MerlinDesigns/hardware/em-controller-2/README.md

# Em Controller Version 2
This smaller Em controller, also affectionately nicknamed "Springspinne" (German for jumping spider), is a hand-held all-button game controller based on the [Em controller](../em-controller) with a focus on being more compact and easier to build. It's running the amazing [GP2040-CE](https://gp2040-ce.info/) firmware.

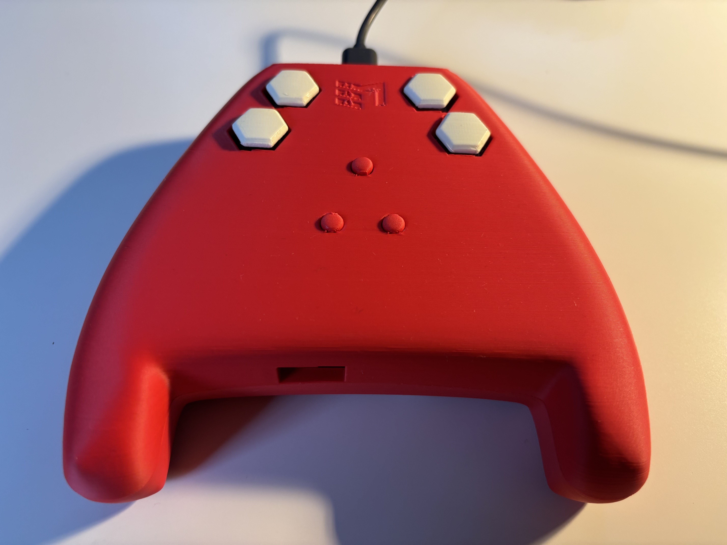
[picture p1: em-controller-2/pictures/em2-top-view.jpg]
Picture of the Em2 from the top. It has two buttons on the top left, two buttons on the top right, and three smaller menu buttons in a cluster in the middle. It is 3D printed in a red color with white hexagonal buttons. A USB-C cable is connected to the controller. The Em2


The idea is that most of the buttons are on the bottom side of the controller
and you can press them with your various fingers. The design aims to let you
use the same fingers for the same buttons you would use on more traditional
leverless controllers.

![Picture of the Em2's bottom. It is 3D printed in red PLA. On that surface, there are
ten white, hexagonal buttons. From this perspective there are seven buttons on the left
and three buttons on the right. The left buttons are clustered similar to
sideways arcade buttons with an additional button on the top. The right buttons are arranged in a staggered line](pictures/em2-bottom-view.jpg "The business end of
the Em2")

This time around there's also a "southpaw" version of the controller:

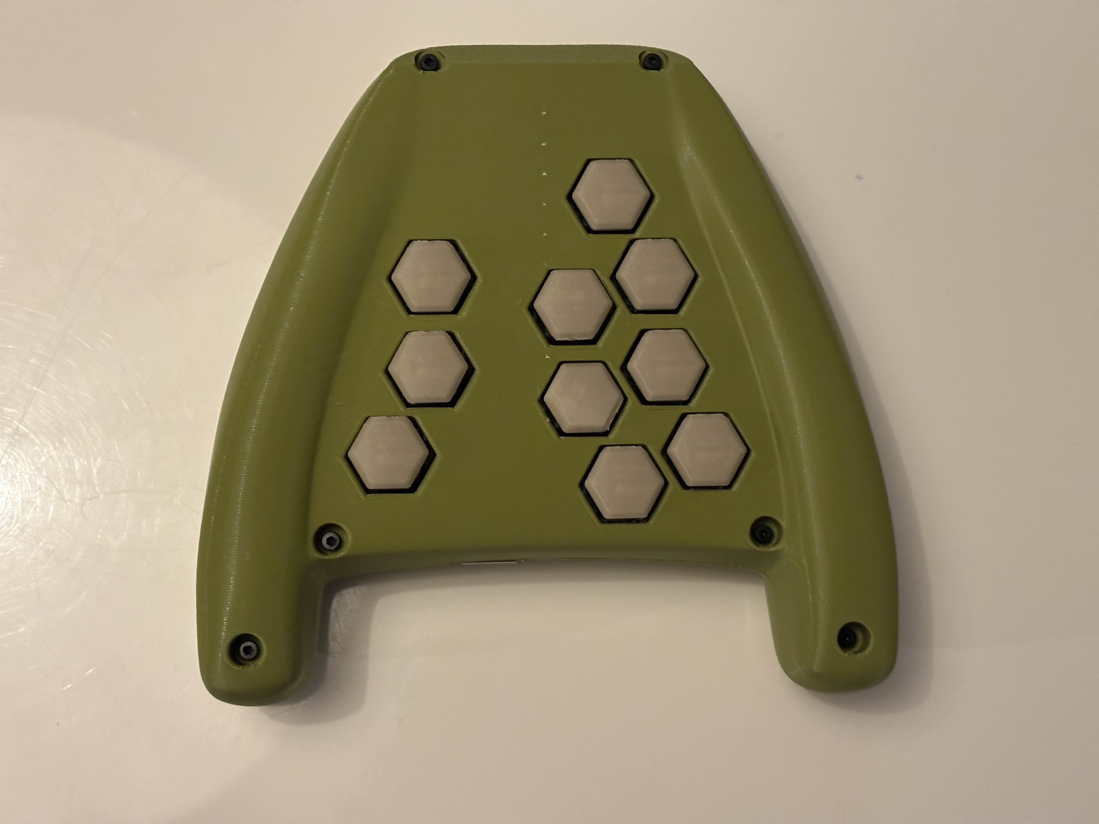
[picture p2: em-controller-2/pictures/southpaw-bottom.jpg]
Picture of the Em2 in olive green with cream colored buttons, bottom side. Here, the cluster of 7 buttons is on the right side of the picture, while the line of 3 buttons is on the left.


This is the button layout I am using (you can change it however you like)
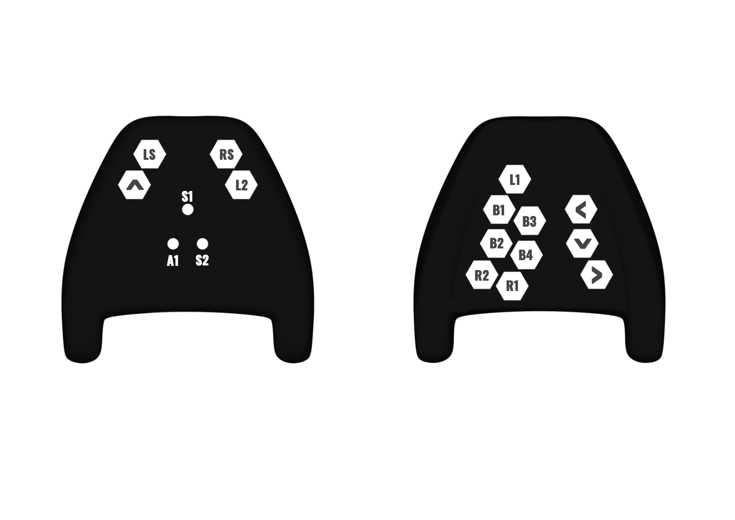
[picture p3: em-controller-2/pictures/springspinne_layout.png]
Diagram of the Em2 and the button assignments


I recorded some videos to make it more clear how its used starting with
a top/front view:

Video showing how the Em2 is used, shot from the front. It shows someone holding the controller and Street Fighter 6 in the background. The player does a simple combo with Blanka in training mode. (https://youtu.be/TEalYefYmOo)

And here is a video from the bottom/back doing the same combo:

Video showing how the Em2 is used, shot from the bottom. Only the controller and two hands wrapping around it are visible. The fingers wiggle around between the different buttons while the player does a simple combo in street fighter 6 (https://youtu.be/E2yLD4zI1v8)

## Why this form factor?
The idea is to have something more like a game pad and the ability to laze
around on the couch while also having the benefits of a leverless controller.
Like a flatbox without having to have the controller on the lap. While you
could just use a gamepad for this purpose, I have been unhappy with most, if
not all, dpads and wanted to be able to not miss the benefits of more detailed
control of directional input.

## How can I get my own?
Some soldering equipment and skill is required for both the handwired and the PCB version. The handwired variants are entirely 3D printed and then soldered with wires, the PCB version can be ordered from the PCB production service of your choice but will still require some soldering of components.

There are a few variants to decide between when building your own controller.
First of all, there is the decision whether you want to build the left-handed (southpaw)
or right-handed (regular) version. For either, there are separate folders including
different print files.

Secondly, the shell files come either with or without prebuilt supports. The
prebuilt supports can help with preventing the controller from being printed
unevenly but aren't strictly needed and might also leave some marks on the
shell.

Whether you pick the PCB or the handwired version, the files are the same but for the fact that you don't need the PCB-replacement files for the real PCB version and the menu buttons are a different size for PCB and handwired version.
### What you'll need for the PCB version
- 1x printed top shell
- 1x printed bottom shell
- 14x printed button caps from `right-handed/buttons/hex-buttons.stl` or 14x of the printed flat button caps from `right-handed/buttons/flat-hex-buttons.stl`
- 3x printed menu buttons from `right-handed/buttons/menu-button-pcb.stl`
- 1x printed bottom switch support from `right-handed/pcb-files/switchfence.stl`
- 1x printed top switch support from `right-handed/pcb-files/switchfence-top.stl` 
- 1x PCB (see below on how to order this)
- 1x Waveshare RP2040-Zero (or equivalent)
- 14x Cherry MX-style full-sized keyboard switches (I have used Cherry MX Speed
  Silver and Akko V3 Silver Pro and I prefer the Akko ones)
- 4x 6mm x 6mm x 8mm push buttons or similar
- 1x female USB A port
- 6x 16mm m2 screws
- 4x 6mm m2 screws
- 10x m2 nuts

top view of the assembled PCB


bottom view of the assembled PCB


When assembling, you need to make sure that the legs of the 6mm x 6mm buttons that overlap with the keyboard switches are snipped off, so that they don't keep the keyboard switches from sitting flush. Two legs being soldered on are enough to provide the functionality and the stability you need. 

When soldering the Waveshare board to the PCB, try to make sure it is soldered on straight and evenly spaced on both sides. Otherwise, the USB plug won't sit correctly in the controller case. You can try soldering on the board using just one of the pins and then check the fit with the case if you are in doubt. For fit checks, it's recommended to also screw the board into the top shell piece to make sure the alignment is correct.

#### How to Order the PCBs
1. Go to JLCPCB.com
2. Click on "Order now"
3. Click on "Add gerber file" and choose "gerber-springspinne.zip"
4. Use the default options (see reference at the end of these instructions), except those mentioned here:
    - PCB Color: choose your color, we would recommend purple
    - Surface Finish: HASL, we would recommend LeadFree
    - Confirm Production file: Yes
5. Click "SAVE TO CART"

Please bear in mind: Do this at your own risk. It is your own responsibility to do the ordering process. We are not responsible for any mistakes in this instruction, as the actual ordering process might change at any time.
<details><summary>Click to see default options for reference</summary>

    PCB: 
    - Base Material: FR-4
    - Layers: 2
    - Dimensions: do not touch
    - PCB Qty: 5 is minimum
    - Product Type: Industrial/Consumer electronics
    - Different Design: 1
    - Delivery Format: Single PCB
    - PCB Thickness: 1.6mm
    - Silkscreen: White
    - Outer Copper Weight: 1oz
    - Via Covering: Tented
    - Min via hole size/diameter 0.3mm
    - Board Outline Tolerance: +/-0.2mm
    - Mark on PCB: Remove Mark
    - Electrical Test: Flying Probe Fully Test
    - Gold Fingers. No
    - Castellated Holes: No
    - Edge Plating: No
</details>

### What you'll need for the handwired version
- 1x printed top shell
- 1x printed bottom shell
- 14x printed button caps from `<layout-choice>/buttons/hex-buttons.stl` or 14x of the printed flat button caps from `<layout-choice>/buttons/flat-hex-buttons.stl`
- 3x printed menu buttons from `<layout-choice>/buttons/menu-button-handwired.stl`
- 1x printed switch support plate from `<layout-choice>/pcb-replacement/switch-support-plate.stl`
- 1x printed menu support plate from `<layout-choice>/pcb-replacement/menu-button-holder.stl`
- 1x printed waveshare holder from `<layout-choice>/pcb-replacement/board-holder.stl`
- 1x Waveshare RP2040-Zero (or equivalent)
- 14x Cherry MX-style full-sized keyboard switches (I have used Cherry MX Speed
  Silver and Akko V3 Silver Pro and I prefer the Akko ones)
- 4x Kailh Silent switch for mice (or similarly sized substitutions)
- 4x m2 heat set inserts (I use Ruthex)
- 1x female USB A breakout board. I got [these
  ones](https://www.amazon.de/Keenso-Breakout-Female-Adapter-Connector/dp/B07VBRTDVF) 
- 6x 16mm m2 screws
- 8x 6mm m2 screws
- 10x m2 nuts
- a bunch of wire to connect everything (I use AWG 26 stranded wire but other wire will work the same)

Inside picture of the Em2. Everything is printed in red matte PLA. There is a Waveshare RP2040-Zero on the inside. A lot of cables connected to the RP2040-Zero via soldering. The controller's insides


Picture of the Em2 switch support plate from the other side showing where the cables go on the other side. The controller's inside, flip side


### Printing Notes

The shell halves are designed to be printed standing on their "noses", which is
why there is a flat plane on those noses. This is not the prettiest, but
a good trade-off to get a nice print. This way the controller can be printed at
a 45 degree angle, which should also work well with the hexagonal cutouts for
the buttons. The inside of the shells should be on the upside when printing to
avoid having to use a lot of supports for the different standoffs etc.

Print settings for the shells should be fine with mostly defaults. My
recommendation is to enable tree supports but only from the build plate to
prevent supports within the nut slots. Other than that you can change infill
settings however you like. Let me know if you encounter problems with printing
so I can make adjustments. I tested the print in PLA and PETG.

Fun fact: You can fit both shell halves on the build plate of Bambu Lab A1 mini.

Print the menu buttons on their flat side edge without supports.

I've had success with printing the hexagonal button caps on one of their edges
with normal supports enabled and two raft layers. This allows the convex shape to be printed
without problems.

If the button caps come out inconsistent on your printer, you can use the flat hex buttons instead. These can just be printed face down and should come out nicely. You should probably enable "detect thin walls" or similar in your slicer.

The switch support plate has a chamfer on one edge that I recommend to use to
print on. Tree supports are required for this print.

I usually print the menu button holder face down with normal supports. This
will require removal of the supports with some tweezers or similar. 

The waveshare board holder arm can easily be printed without supports.

## Thank You

Big thanks to [Alpenmeister](https://alpenmeister.com/en) for being a constant sounding board on the design and especially for his work on the PCB.

Thank you to Giga on the GP2040-CE Discord for giving the design a spin and everyone else on the GP2040-CE Discord for advice and encouragement throughout development.

## Support
If you want to support this project you can [buy me
a coffee](https://ko-fi.com/merlindesigns).

## License
This project is published under [CC BY-NC-SA
4.0](https://creativecommons.org/licenses/by-nc-sa/4.0/). If you want to sell
this design, please contact me first.

If you have questions, you can find me (@Merlin) in the [Open Stick Community
Discord Server](https://discord.com/servers/openstickcommunity-1049366310389289001). Or @merlindesigns.bsky.social on Bluesky.
