MerlinDesigns/hardware/flatbox-box/README.md

# Flatbox Box

**WIP**

Currently just a silly idea on how you could support a flatbox on your lap at
your local. This is completely unproven as of writing.
