MerlinDesigns/hardware/em-controller-2/pictures/em2-bottom-view.jpg

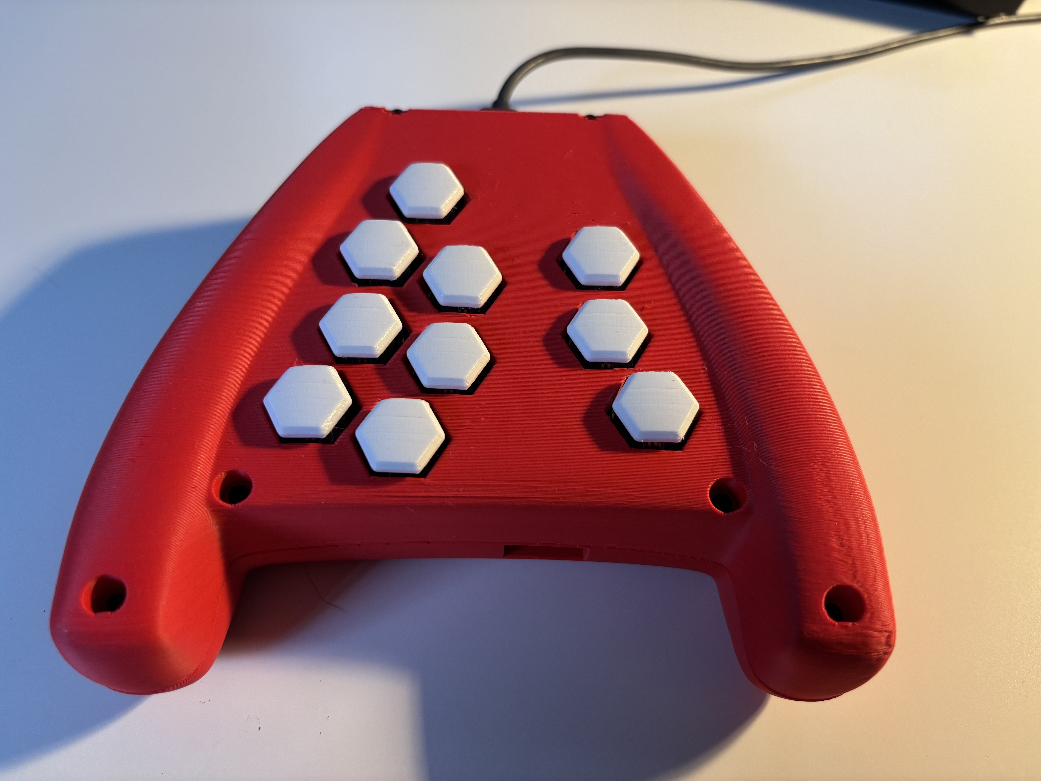
em-controller-2/pictures/em2-bottom-view.jpg
