MerlinDesigns/hardware/em-controller-2/pictures/southpaw-top.jpg

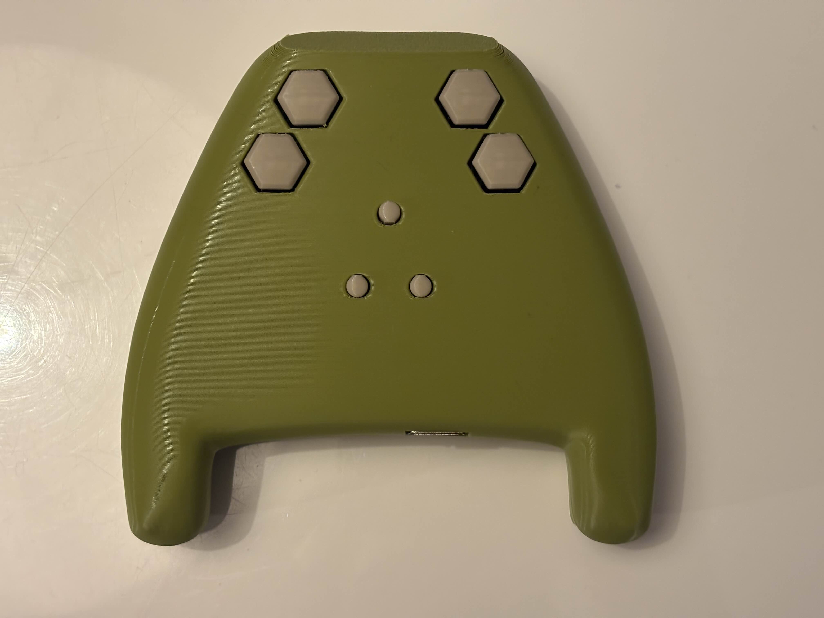
em-controller-2/pictures/southpaw-top.jpg
