MerlinDesigns/hardware/em-controller/pictures/bottom-slice.png

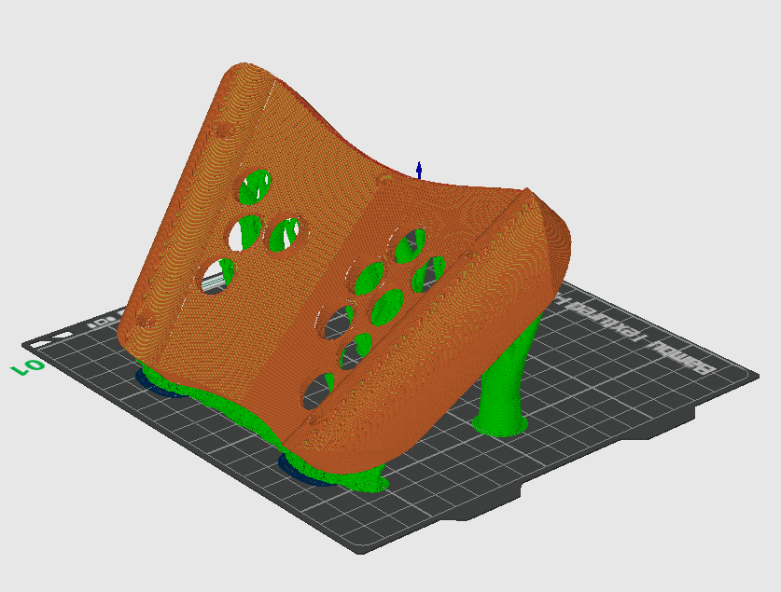
em-controller/pictures/bottom-slice.png
