MerlinDesigns/hardware/em-controller/pictures/em-controller-bottom-pinout.png

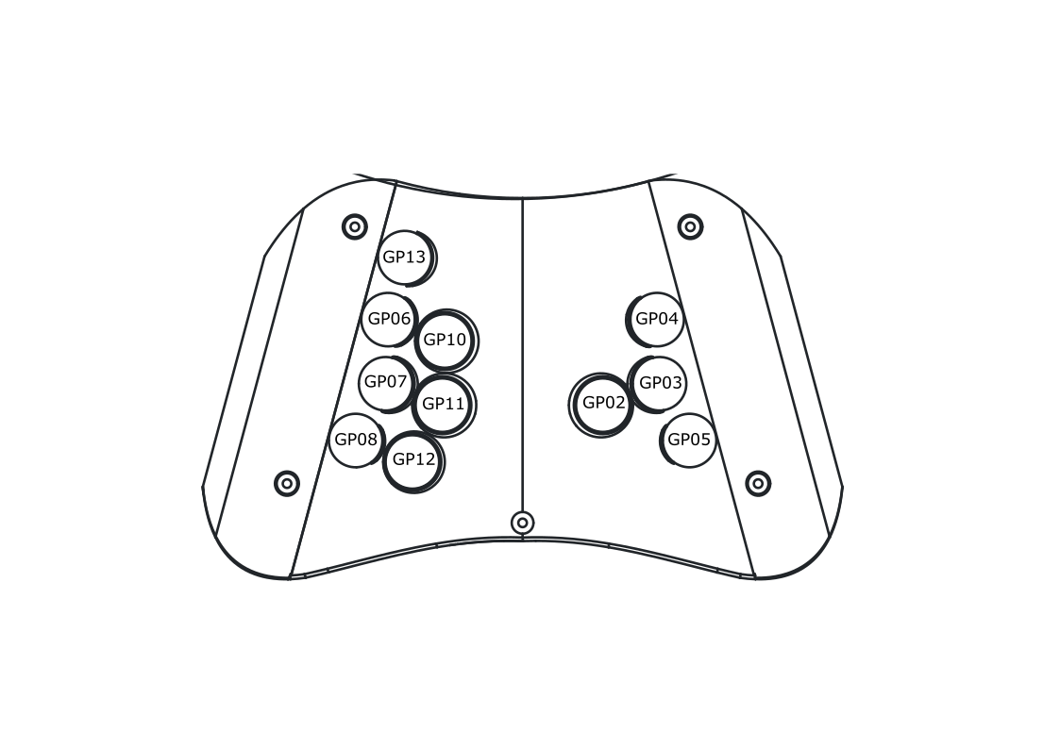
em-controller/pictures/em-controller-bottom-pinout.png
