MerlinDesigns/hardware/em-controller/pictures/holding.jpg

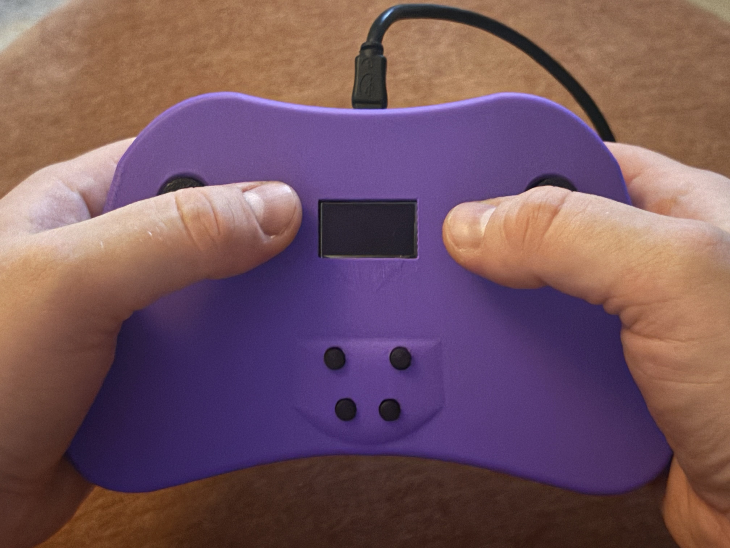
em-controller/pictures/holding.jpg
