MerlinDesigns/hardware/em-controller/pictures/outside-pic-bottom.jpg

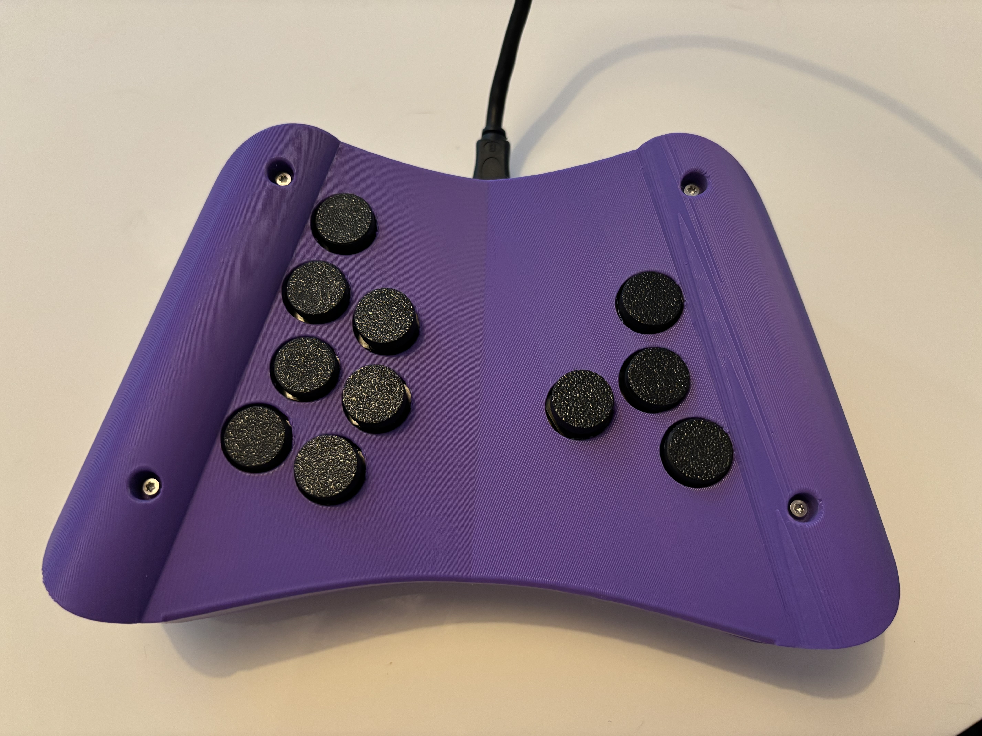
em-controller/pictures/outside-pic-bottom.jpg
