MerlinDesigns/hardware/em-controller-2/left-handed/buttons/flat-hex-buttons.stl

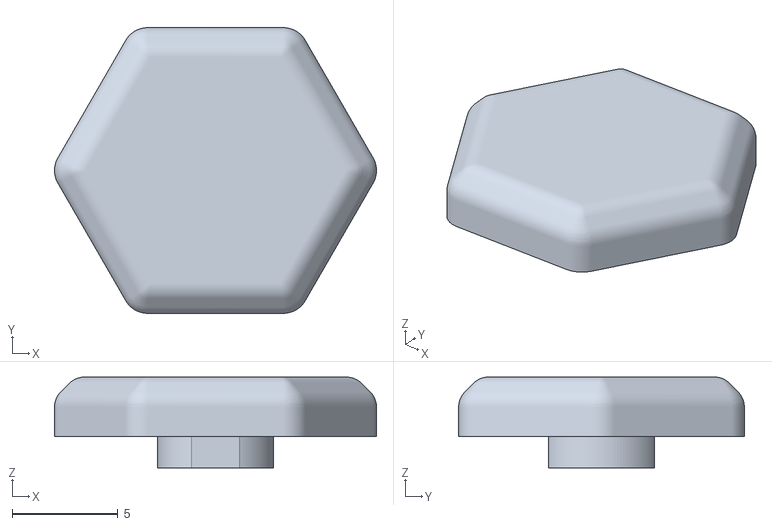
[picture p18: CAD file, 2025-11-20]
em-controller-2/left-handed/buttons/flat-hex-buttons.stl
15.2 x 13.5 x 4.30
