MerlinDesigns/hardware/em-controller-2/left-handed/pcb-replacement/menu-button-holder.stl

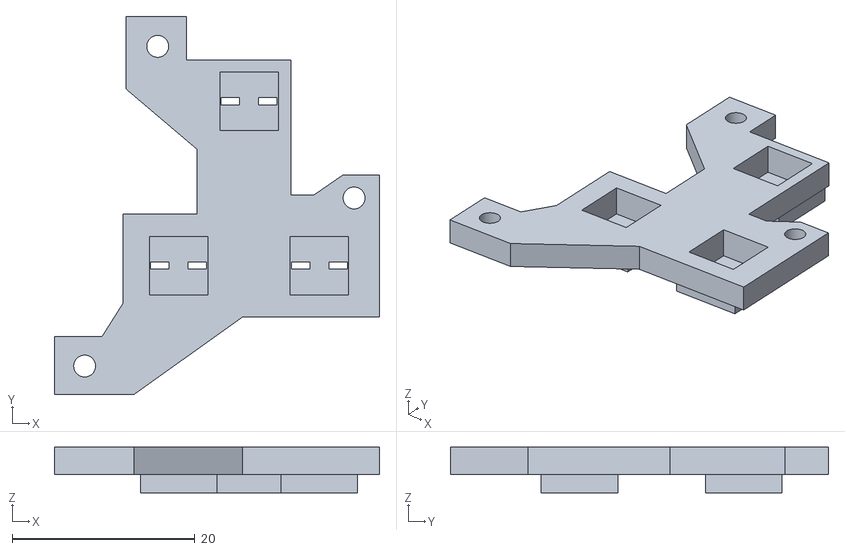
[picture p19: CAD file, 2025-11-13]
em-controller-2/left-handed/pcb-replacement/menu-button-holder.stl
35.6 x 41.4 x 5.00
