MerlinDesigns/hardware/em-controller-2/right-handed/buttons/menu-button-pcb.stl

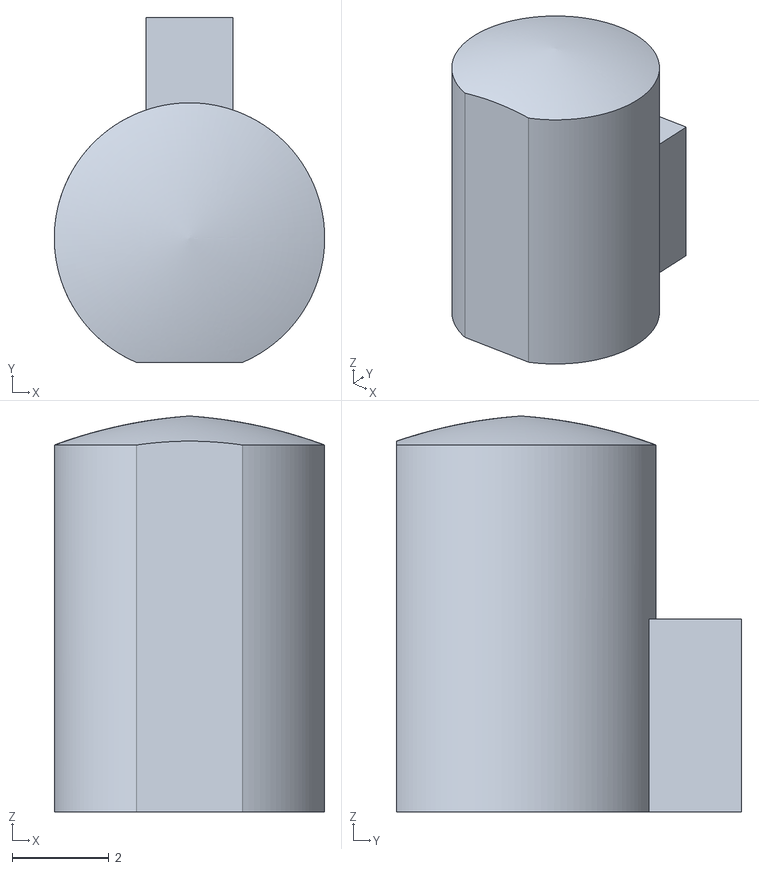
[picture p20: CAD file, 2025-12-09]
em-controller-2/right-handed/buttons/menu-button-pcb.stl
5.60 x 7.15 x 8.20
