MerlinDesigns/hardware/em-controller-2/right-handed/pcb-files/switchfence-top.stl

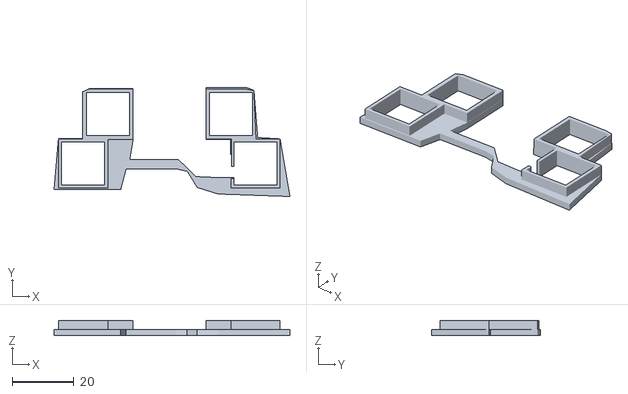
[picture p21: CAD file, 2025-12-09]
em-controller-2/right-handed/pcb-files/switchfence-top.stl
76.6 x 35.4 x 5.00
