MerlinDesigns/hardware/em-controller/model files/em-controller-menu-button-top.3mf

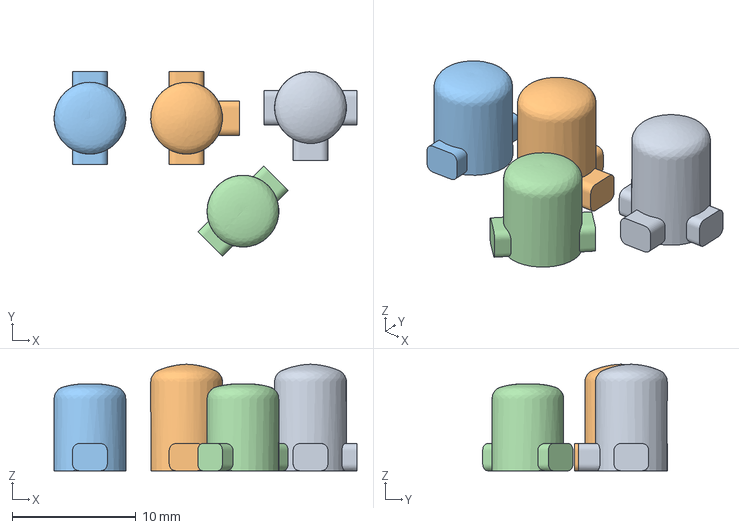
[picture p22: CAD file, 2024-12-14]
em-controller/model files/em-controller-menu-button-top.3mf
24.4 x 14.9 x 8.60 mm
em-controller-menu-button-top.stl x 2
em-controller-menu-button-bottom.stl x 2
