MerlinDesigns/hardware/em-controller/print files/button-print.3mf

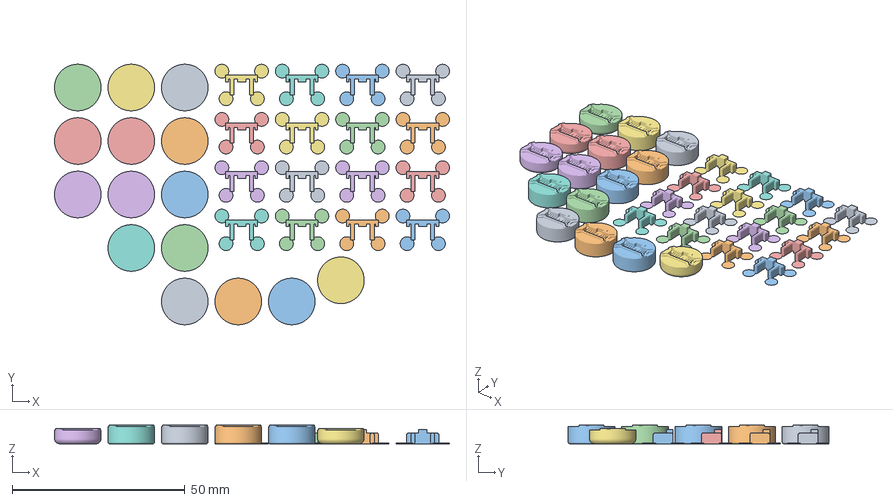
[picture p23: CAD file, 2024-12-14]
em-controller/print files/button-print.3mf
114.4 x 75.5 x 5.41 mm
stem_pads_r6.STL x 16
buttoncaps-bottom.stl x 11
buttoncaps-top.stl x 4
