MerlinDesigns/hardware/flatbox-box/flatboxbox.FCStd

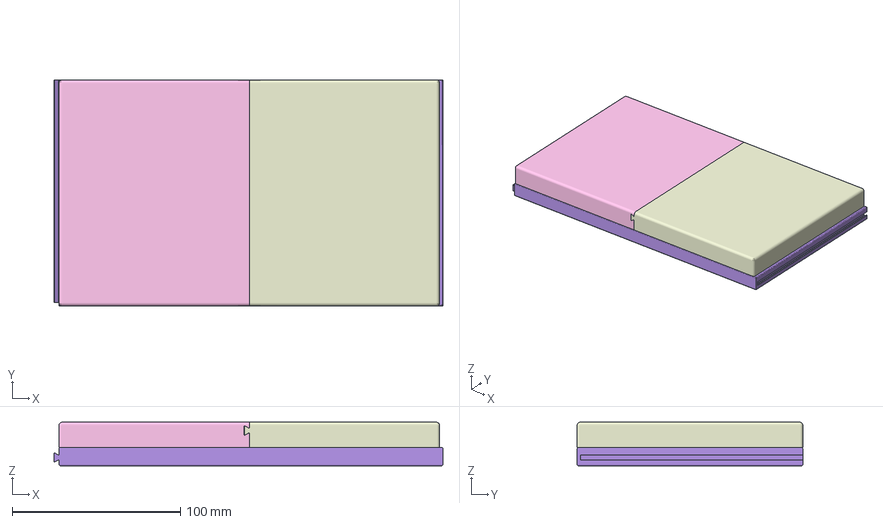
[picture p24: CAD file, 2024-08-21]
flatbox-box/flatboxbox.FCStd
230.9 x 134.0 x 26.0 mm
bottom
topleft
topRight
Flatbox-rev5-Bottom-hotswap
Flatbox-rev5-Top
