MerlinDesigns/hardware/mini-arcade-button/mini-arcade-button.FCStd

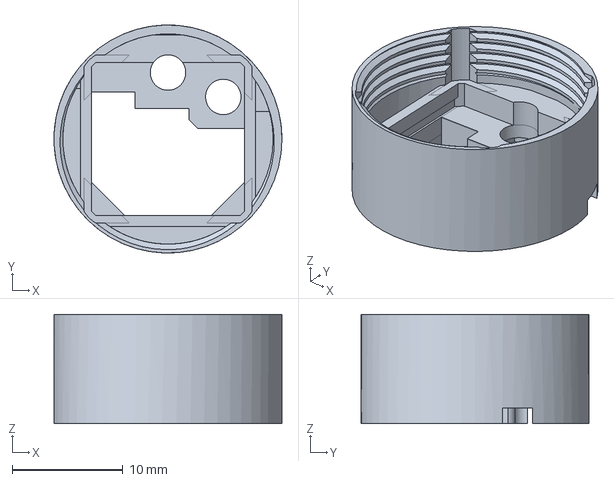
[picture p25: CAD file, 2024-08-14]
mini-arcade-button/mini-arcade-button.FCStd
20.6 x 20.6 x 9.85 mm
