MerlinDesigns/hardware/mini-arcade-button/print files/stem_r6.STL

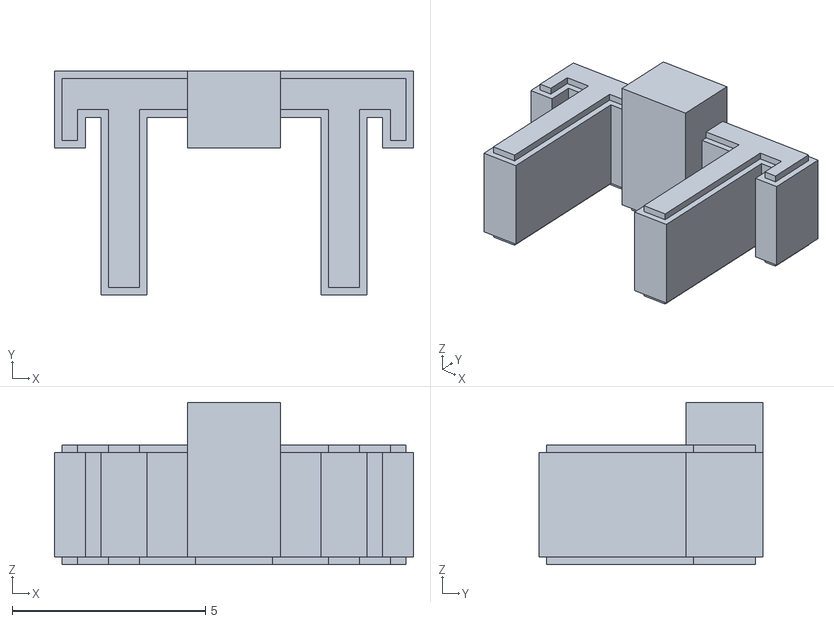
[picture p26: CAD file, 2024-08-14]
mini-arcade-button/print files/stem_r6.STL
9.29 x 5.80 x 4.20
