MerlinDesigns/hardware/em-controller-2/left-handed/buttons/hex-buttons.stl

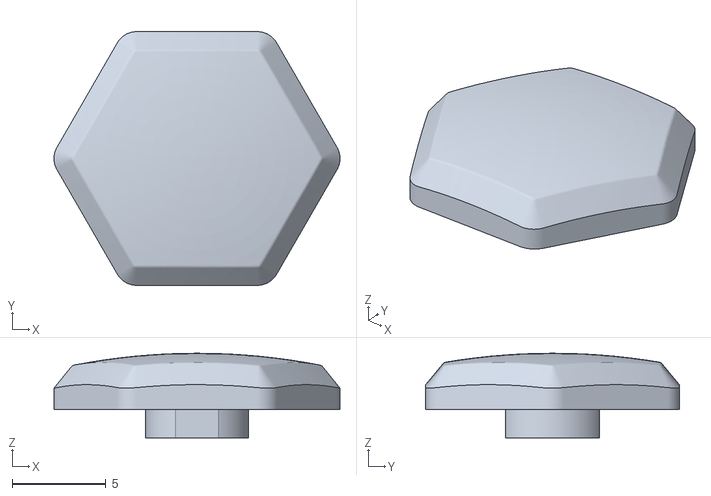
[picture p27: CAD file, 2025-11-13]
em-controller-2/left-handed/buttons/hex-buttons.stl
15.2 x 13.5 x 4.50
