MerlinDesigns/hardware/em-controller-2/left-handed/pcb-replacement/switch-support-plate.stl

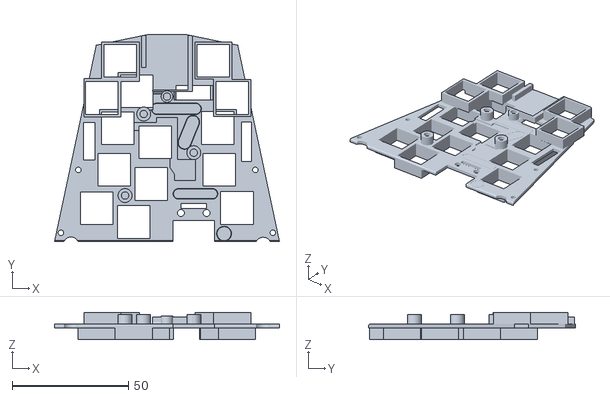
[picture p28: CAD file, 2025-11-13]
em-controller-2/left-handed/pcb-replacement/switch-support-plate.stl
96.6 x 89.0 x 11.6
