MerlinDesigns/hardware/em-controller-2/right-handed/pcb-files/switchfence.stl

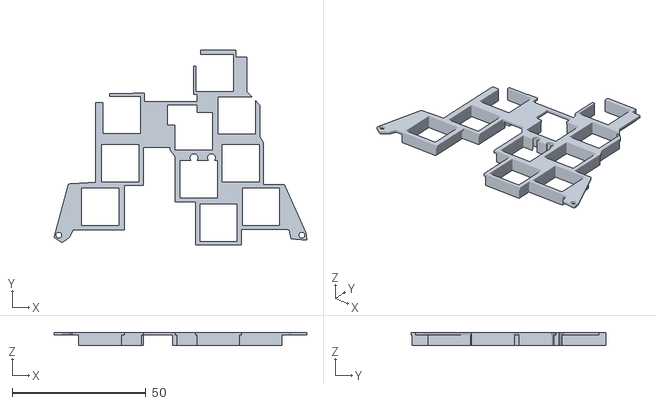
[picture p29: CAD file, 2025-12-09]
em-controller-2/right-handed/pcb-files/switchfence.stl
94.7 x 73.0 x 5.00
