MerlinDesigns/hardware/em-controller/model files/em-controller-menu-button-bottom.stl

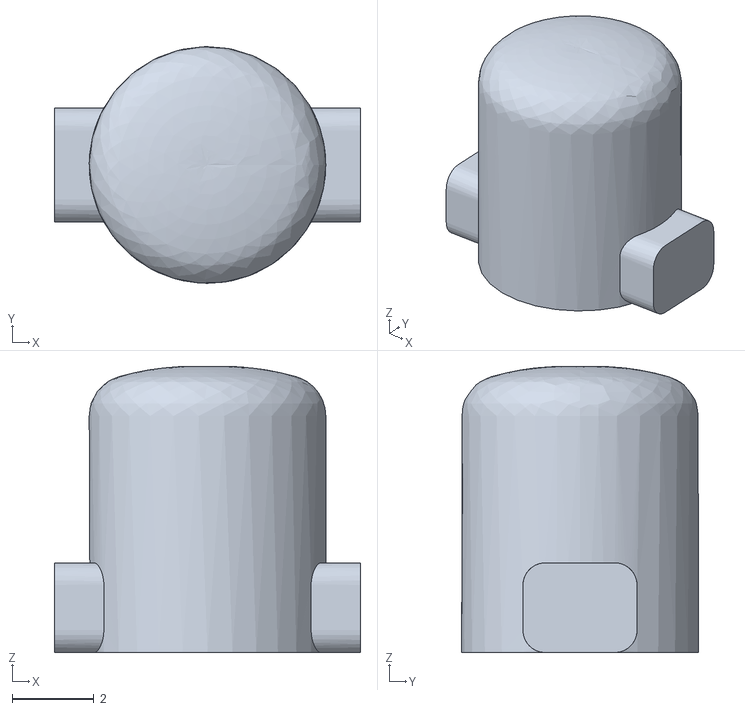
[picture p30: CAD file, 2024-12-14]
em-controller/model files/em-controller-menu-button-bottom.stl
7.50 x 5.80 x 7.01
