MerlinDesigns/hardware/em-controller/print files/em-controller-topsupport.3mf

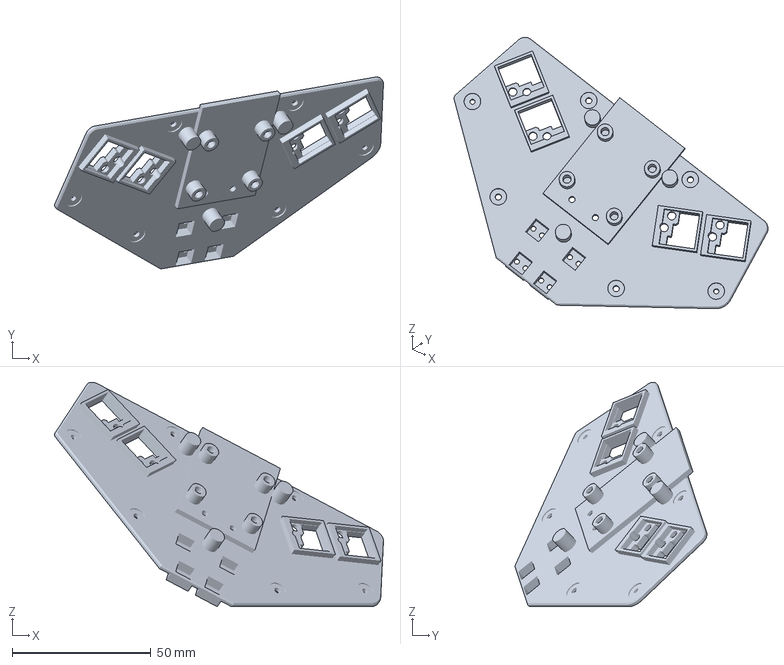
[picture p31: CAD file, 2024-09-05]
em-controller/print files/em-controller-topsupport.3mf
118.4 x 69.1 x 80.8 mm
