MerlinDesigns/hardware/flatbox-box/flatboxbox-topRight.stl

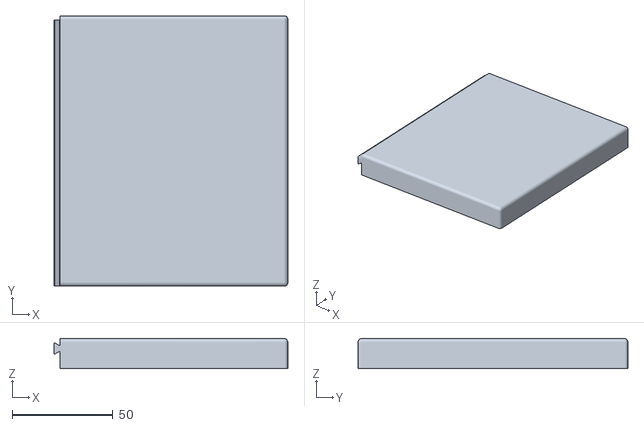
[picture p32: CAD file, 2024-08-21]
flatbox-box/flatboxbox-topRight.stl
116.0 x 134.0 x 15.0
