MerlinDesigns/hardware/mini-arcade-button/print files/top.stl

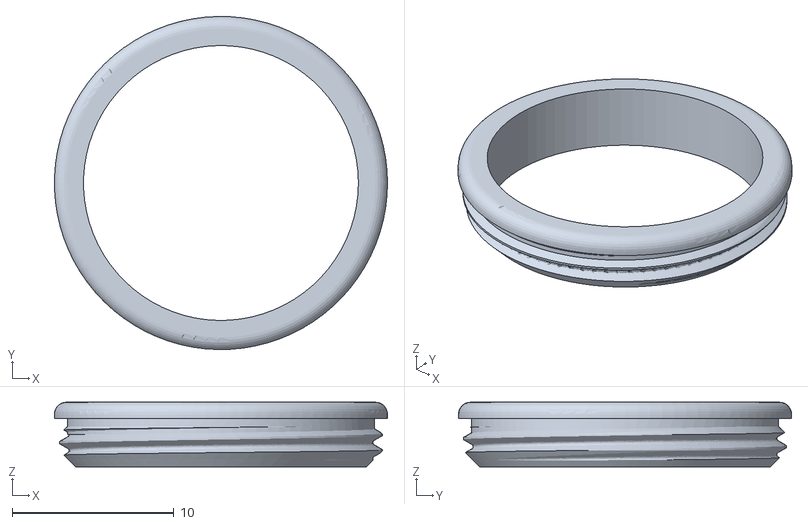
[picture p33: CAD file, 2024-08-14]
mini-arcade-button/print files/top.stl
20.6 x 20.6 x 4.00
