MerlinDesigns/hardware/em-controller-2/left-handed/buttons/menu-button.stl

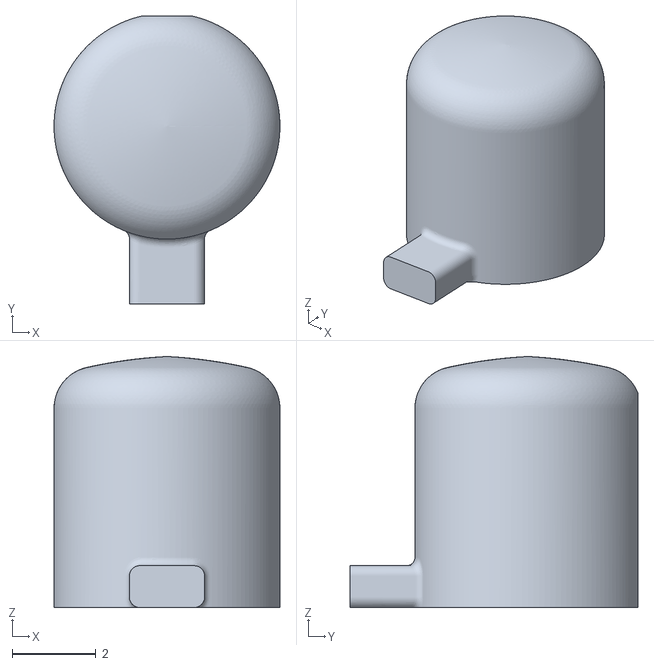
[picture p34: CAD file, 2025-11-13]
em-controller-2/left-handed/buttons/menu-button.stl
5.40 x 6.88 x 6.00
