MerlinDesigns/hardware/em-controller-2/left-handed/pcb-replacement/board-holder.stl

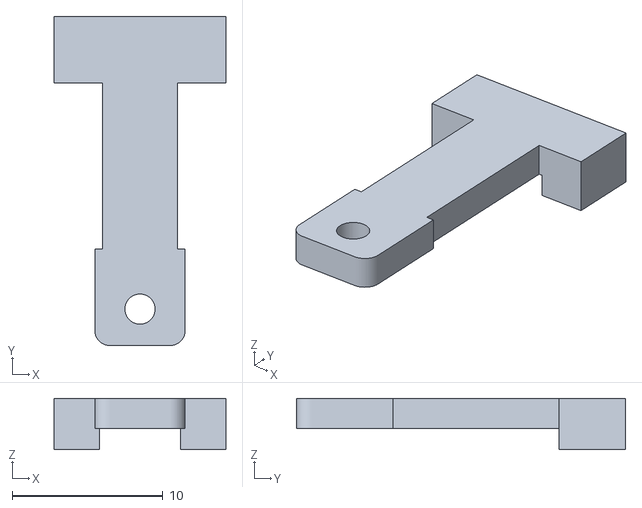
[picture p35: CAD file, 2025-11-13]
em-controller-2/left-handed/pcb-replacement/board-holder.stl
11.4 x 21.8 x 3.40
