MerlinDesigns/hardware/em-controller/model files/buttoncaps-chocv2-top.stl

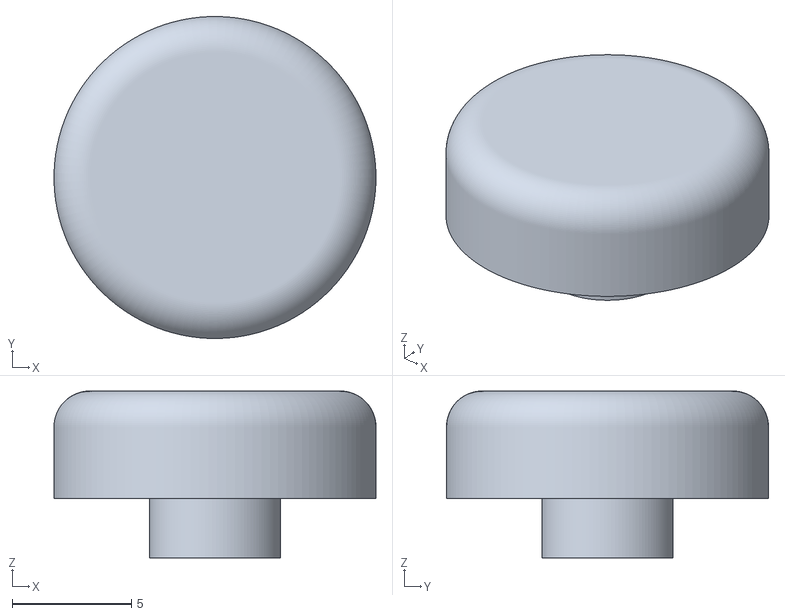
[picture p36: CAD file, 2024-10-31]
em-controller/model files/buttoncaps-chocv2-top.stl
13.5 x 13.5 x 7.00
