MerlinDesigns/hardware/em-controller/print files/em-controller-bottom.3mf

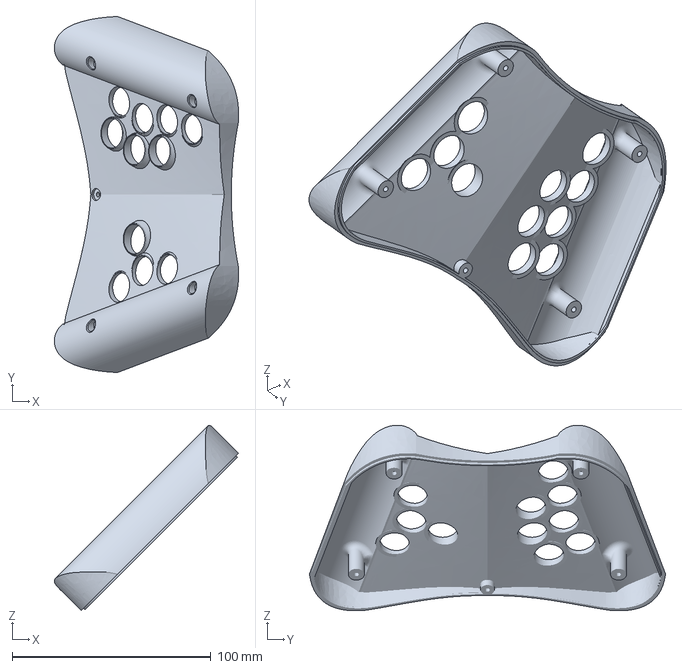
[picture p37: CAD file, 2024-09-05]
em-controller/print files/em-controller-bottom.3mf
92.8 x 179.2 x 93.4 mm
