MerlinDesigns/hardware/flatbox-box/flatboxbox-topleft.stl

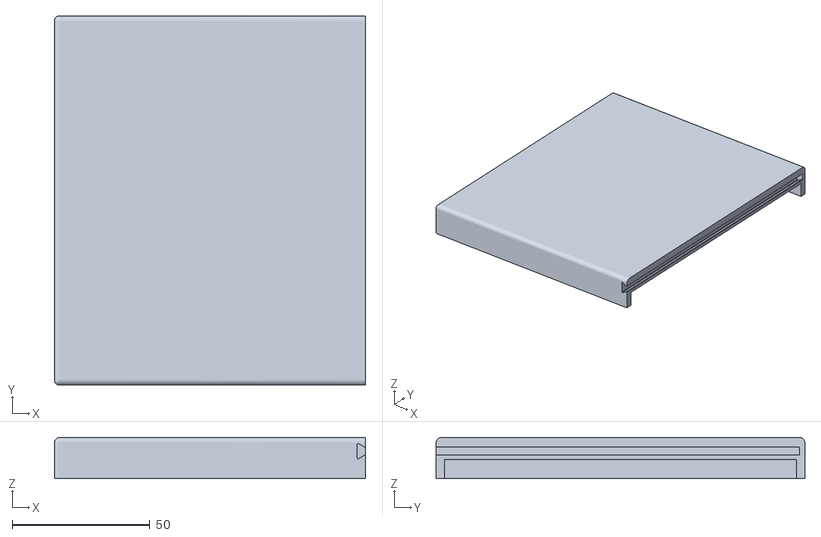
[picture p38: CAD file, 2024-08-21]
flatbox-box/flatboxbox-topleft.stl
113.0 x 134.0 x 15.0
