MerlinDesigns/hardware/mini-arcade-button/print files/modularcap-16mm.stl

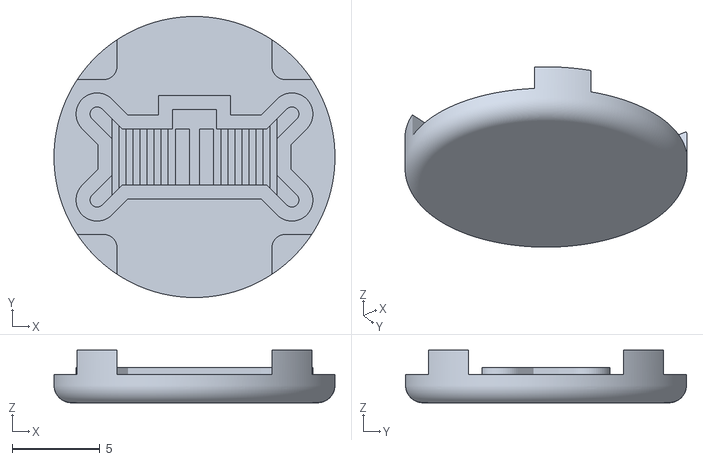
[picture p39: CAD file, 2024-08-14]
mini-arcade-button/print files/modularcap-16mm.stl
16.0 x 16.0 x 3.00
