MerlinDesigns/hardware/em-controller/model files/buttoncaps-chocv2-bottom.stl

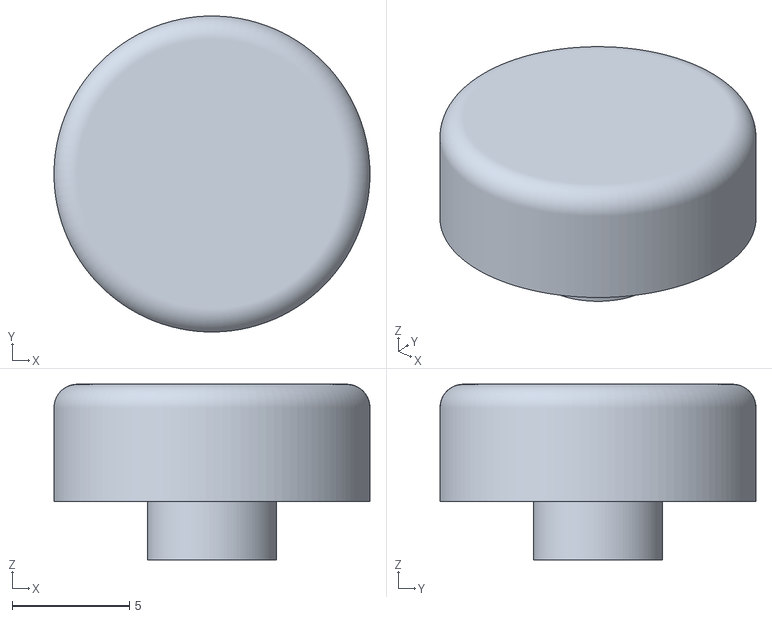
[picture p40: CAD file, 2024-10-31]
em-controller/model files/buttoncaps-chocv2-bottom.stl
13.5 x 13.5 x 7.50
