MerlinDesigns/hardware/em-controller/print files/em-controller-top.3mf

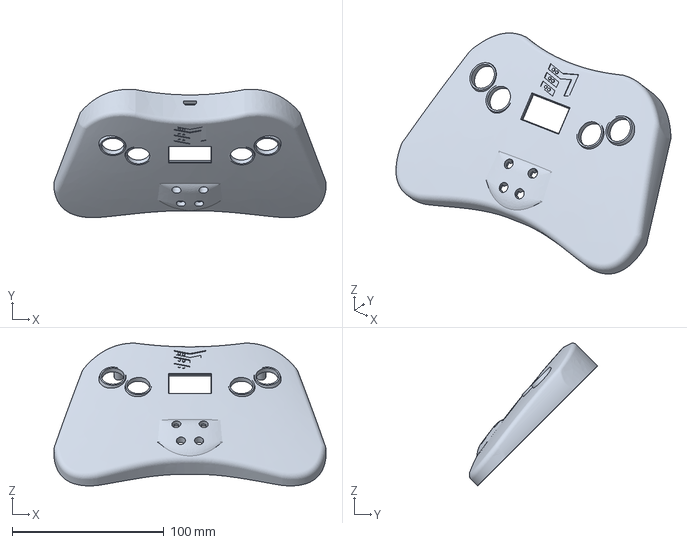
[picture p41: CAD file, 2024-08-28]
em-controller/print files/em-controller-top.3mf
179.4 x 84.7 x 94.2 mm
