MerlinDesigns/hardware/flatbox-box/flatboxbox-bottom.stl

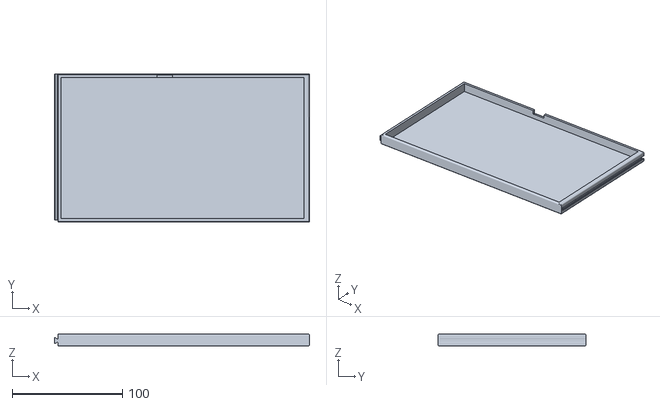
[picture p42: CAD file, 2024-08-21]
flatbox-box/flatboxbox-bottom.stl
230.9 x 134.0 x 11.0
