MerlinDesigns/hardware/mini-arcade-button/print files/print-buttonhousing.3mf

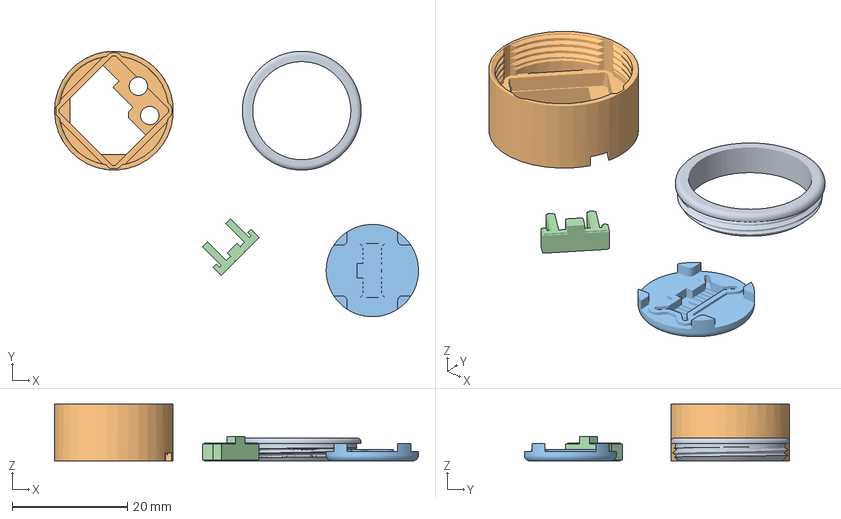
[picture p43: CAD file, 2024-08-14]
mini-arcade-button/print files/print-buttonhousing.3mf
63.1 x 46.0 x 9.85 mm
kailhplateremix-edgecap2.stl
kailhplateremix-buttonhousing2.stl
modularcap-16mm.stl
stem_r6.STL
