MerlinDesigns/hardware/em-controller/model files/buttoncaps.FCStd

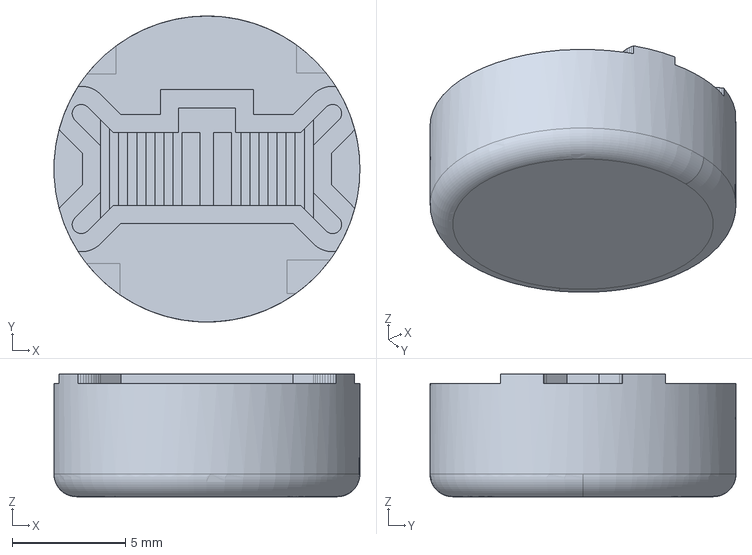
[picture p44: CAD file, 2024-09-05]
em-controller/model files/buttoncaps.FCStd
13.5 x 13.5 x 5.41 mm
