MerlinDesigns/hardware/em-controller/print files/em-controller-bottom-supportt.3mf

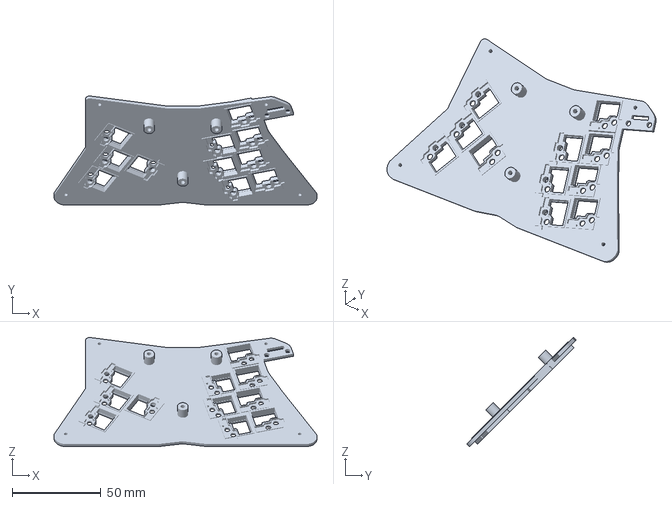
[picture p45: CAD file, 2024-08-28]
em-controller/print files/em-controller-bottom-supportt.3mf
148.4 x 61.5 x 61.5 mm
