MerlinDesigns/hardware/em-controller/model files/em-controller-bottomsupport.stl

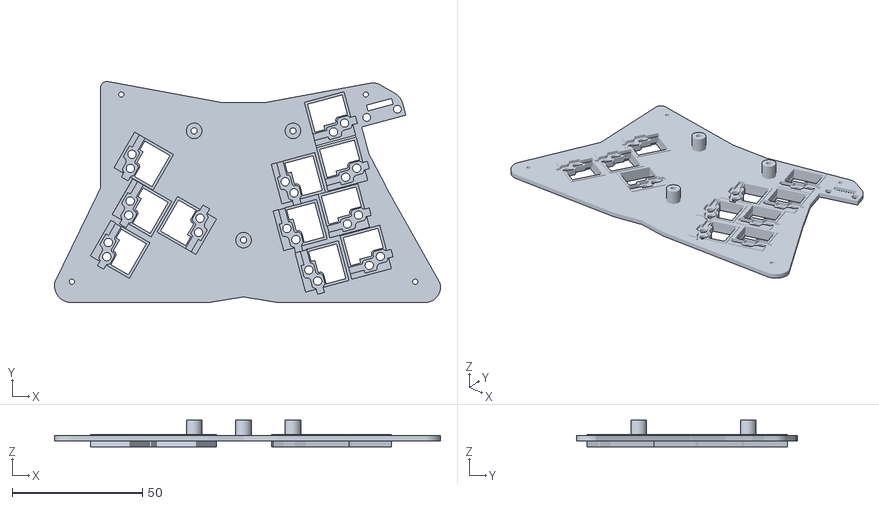
[picture p46: CAD file, 2024-08-28]
em-controller/model files/em-controller-bottomsupport.stl
148.4 x 85.0 x 10.4
