MerlinDesigns/hardware/em-controller/model files/stem_pads_r6.STL

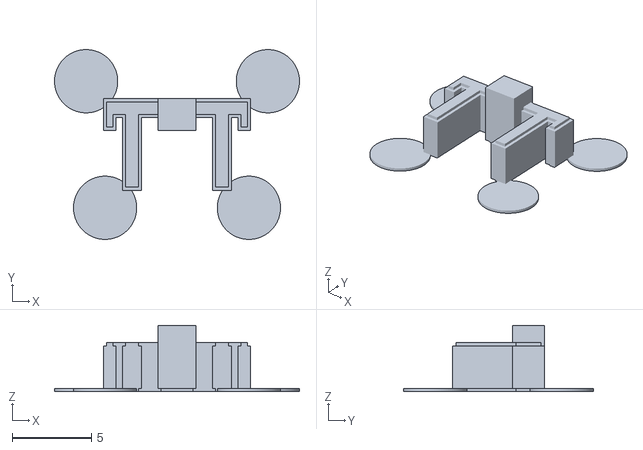
[picture p47: CAD file, 2024-08-14]
em-controller/model files/stem_pads_r6.STL
15.5 x 12.0 x 4.20
