MerlinDesigns/hardware/em-controller/model files/modularbuttoncaps-14mm-4_9mm.step

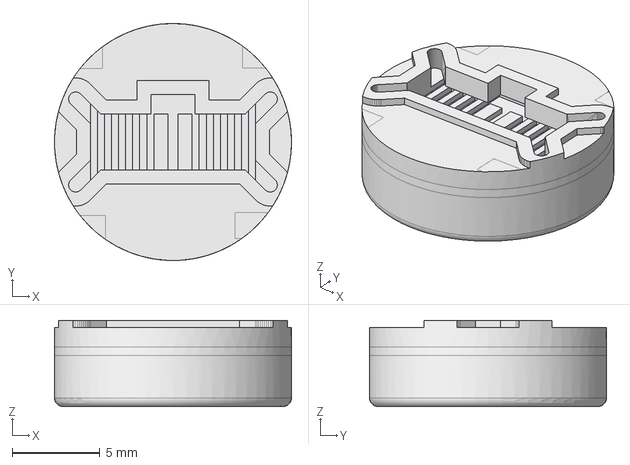
[picture p48: CAD file, 2024-08-14]
em-controller/model files/modularbuttoncaps-14mm-4_9mm.step
13.5 x 13.5 x 4.91 mm
