MerlinDesigns/hardware/(list of files, cad)

Other CAD files:
em-controller-2/right-handed/pcb-replacement/menu-button-holder.stl
em-controller-2/right-handed/pcb-replacement/switch-support-plate.stl
mini-arcade-button/print files/buttonhousing.stl
em-controller/model files/modularbuttoncaps-14mm-5_4mm.stl
em-controller/model files/em-controller-bottom.stl
em-controller/model files/em-controller-menu-button-top.stl
em-controller/model files/em-controller-topsupport.stl
