MerlinDesigns/hardware/em-controller/printing.md

# Printing Instructions

Printing the top and bottom shell can either be done inside down on the build
plate (with standard supports) or diagonally, standing up, with tree supports
enabled. The inside down printing leads to a less nice surface finish due to
the curves and you need to remove the supports with more effort.

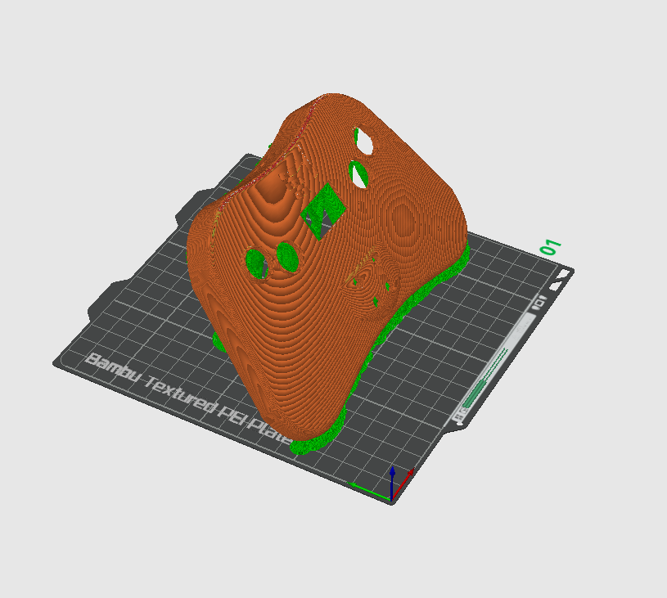
[picture p49: em-controller/pictures/top-slice.png]
picture of the top of the controller being sliced standing up at 45 degrees, being supported by tree supports Slice of top half


On the other hand, the diagonal standing up prints have a nicer surface finish.
You just have to watch out for bed adhesion, which can cause issues when
printing.

![picture of the bottom of the controller being sliced standing up at 45
degrees, being supported by tree supports](pictures/bottom-slice.png "Slice of
the bottom half")

The best orientation for the bottom part of the shell is, similarly to the top,
at a 45 degree angle on the narrow edge that is the furthest away from you when
you are holding it. There is one drawback of this orientation in that the edge
closest to you on the bottom side will not be super smooth due to the curve of
the edge. I often find myself holding my pinkies in that spot and a super
smooth edge would be nicer but it isn't exactly uncomfortable this way either.
If it bothers you, this might need some sanding to rectify.

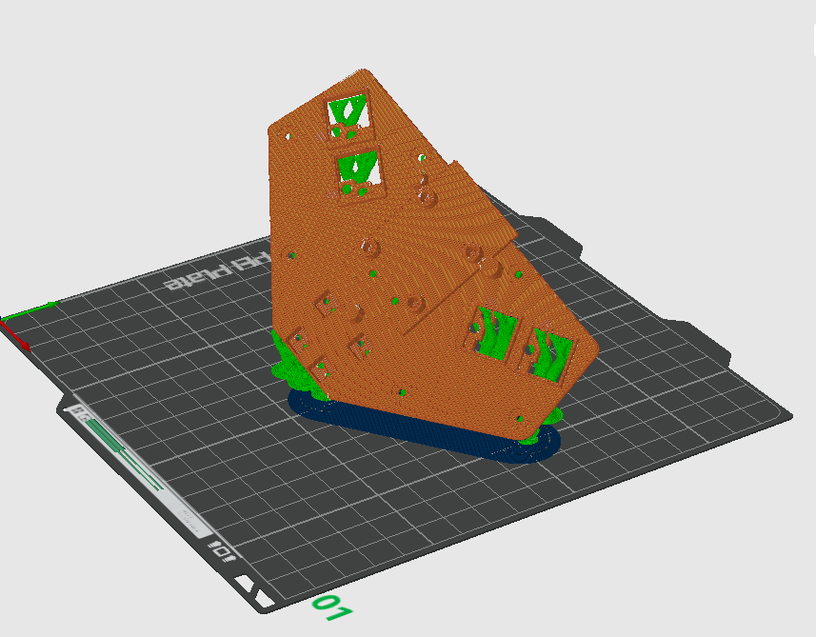
[picture p50: em-controller/pictures/top-support-slice.png]
picture of the top support being sliced standing up at a 45 degree angle Top support slice


The supports plates can also be printed standing up at a 45 degree angle using tree
supports.

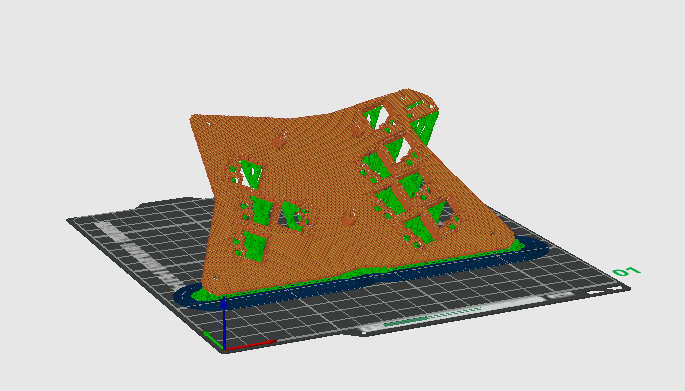
[picture p51: em-controller/pictures/bottom-support-slice.png]
picture of the bottom support being sliced standing up at a 45 degree angle Bottom support slice


## Buttons

The buttons need to be printed using 0.1 mm layers with 3 wall loops and detect
thin walls on. I printed them with 40% infill. You can print the
button caps and the stems all on one plate.

Once printed, the stems need to be cleaned of the pads and then glued into the
caps with some CA glue. Only a little drop is needed to make for a good bond.
I've used some needle nose pliers to make sure the stems sit properly in the
cap. I like to put the stems in without glue first, to make sure they fit well
and then remove and glue them in.

The caps use two components to make for strong stems due to the orientation of
the layer lines. Printing single piece caps leads to stem breakage.
