MerlinDesigns/hardware/em-controller/pdfs/em-controller-pinout.pdf

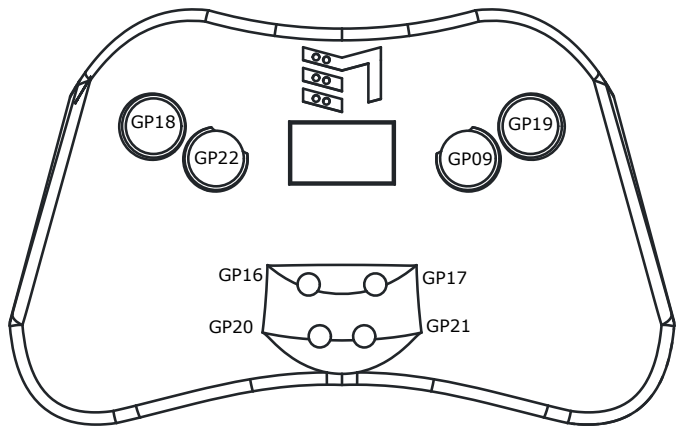
[picture p52: page 1]

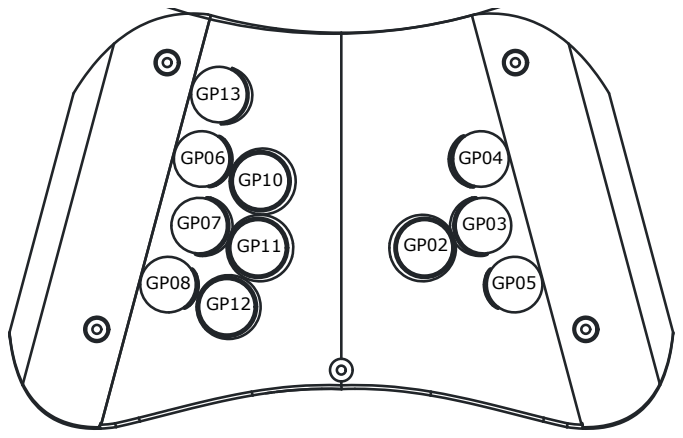
[picture p53: page 2]
