MerlinDesigns/hardware/em-controller/pdfs/em-controller-buttons.pdf

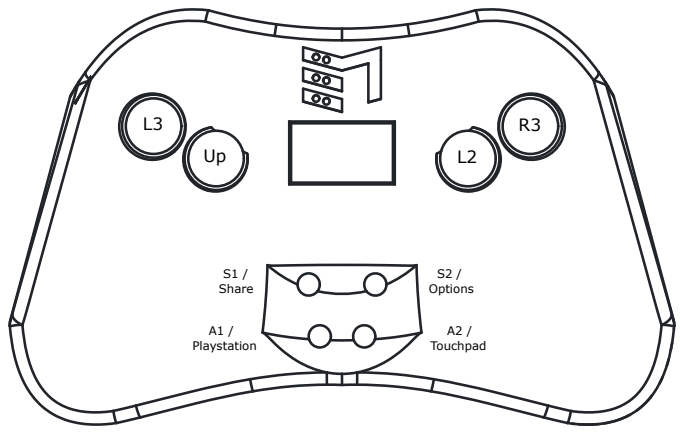
[picture p54: page 1]
S1 / Share; S2 / Options; A1 / Playstation; A2 / Touchpad

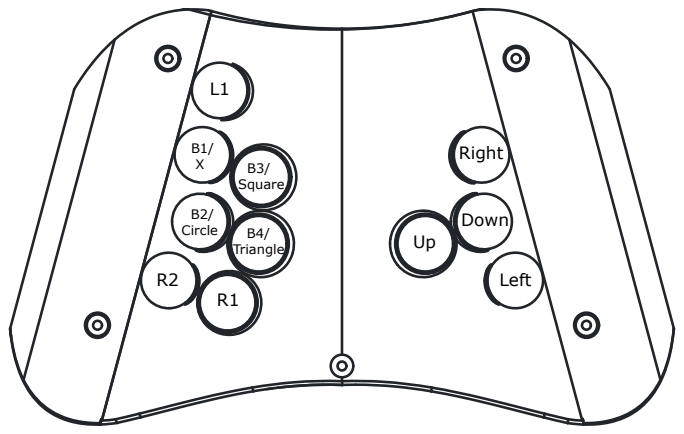
[picture p55: page 2]
Right; Down; Left; Square; Circle; Triangle
