MerlinDesigns/hardware/(commit log)

2024-08-14 initial commit of mini arcade button
    [buttonhousing.stl, mini-arcade-button.FCStd, modularcap-16mm.stl, print-buttonhousing.3mf, stem_r6.STL, top.stl]
2024-08-14 first commit em-controller
    [em-controller-bottom.stl, em-controller-bottomsupport.stl, em-controller-topsupport.stl, hhabc-form-iteration8-bottom.3mf, hhabc-form-iteration8-bottomsupport.3mf, hhabc-form-iteration8-top.3mf, hhabc-form-iteration8-topsupport.3mf, modularbuttoncaps-14mm-4_75mm.step]
2024-08-14 Em controller first version done
    [em-controller-bottom.stl, em-controller-bottomsupport.stl, em-controller-menu-button-bottom.stl, em-controller-menu-button-top.stl, hhabc-form-iteration8-bottom.3mf, hhabc-form-iteration8-bottomsupport.3mf, hhabc-form-iteration8-top.3mf, hhabc-form-iteration8-topsupport.3mf]
2024-08-20 collars, usb inlet position and sizing, added extra standoff, moved OLED up a little bit, added space for USB host
    [em-controller-bottomsupport.stl, em-controller-topsupport.stl]
2024-08-20 Fixed screw sizes
2024-08-21 first flatbox-box commit
    [flatboxbox-bottom.stl, flatboxbox-topRight.stl, flatboxbox-topleft.stl, flatboxbox.FCStd]
2024-08-21 updated rails
    [flatboxbox-bottom.stl, flatboxbox-topRight.stl, flatboxbox-topleft.stl, flatboxbox.FCStd]
2024-08-23 fixed top support plate
    [em-controller-topsupport.stl]
2024-08-26 slight adjustment of overall design file
    [em-controller-top.stl]
2024-08-26 some adjustments for fit
    [em-controller-top.stl, em-controller-topsupport.stl]
2024-08-28 restoring bottom stl
    [buttoncaps.FCStd]
2024-08-28 print files and new images
    [em-controller-top.3mf, em-controller-topsupport.3mf]
2024-08-28 bottomsupport slight size change of cable channel
2024-08-28 add new bottomsupport file
    [em-controller-bottomsupport.stl]
2024-08-28 new picture and print files
    [em-controller-bottom-supportt.3mf]
2024-08-28 menu button changes
2024-08-28 removing tighter menu buttons
2024-08-28 menu button export
    [em-controller-menu-button-bottom.stl, em-controller-menu-button-top.stl]
2024-08-28 button export
    [modularbuttoncaps-14mm-4_9mm.step, modularbuttoncaps-14mm-5_4mm.stl]
2024-08-28 adds button print file
    [button-print.3mf]
2024-08-28 button cap update
    [buttoncaps.FCStd]
2024-08-28 printing page update
2024-09-05 pinout and button pictures
    [button-print.3mf, buttoncaps.FCStd, em-controller-bottom.3mf, em-controller-topsupport.3mf]
2024-10-31 adds support for choc v2 buttons
    [buttoncaps-chocv2-bottom.stl, buttoncaps-chocv2-top.stl]
2025-11-12 em2 basics
    [board-holder.stl, hex-buttons.stl, menu-button-holder.stl, menu-button.stl, pcb-replacement.stl]
2025-11-12 readme update
    [board-holder.stl, menu-button-holder.stl, pcb-replacement.stl, switch-support-plate.stl]
2025-11-13 added southpaw
    [board-holder.stl, hex-buttons.stl, menu-button-holder.stl, menu-button.stl, switch-support-plate.stl]
2025-11-18 flat hex buttons added
    [flat-hex-buttons.stl]
2025-11-18 thin walls print setting
2025-11-20 fixed flat button caps
    [flat-hex-buttons.stl]
2025-12-09 adds PCB version
    [bom.csv, menu-button-handwired.stl, menu-button-pcb.stl, positions.csv, switchfence-top.stl, switchfence.stl]
