MerlinDesigns/hardware/em-controller-2/pictures/pcb-top-view.jpeg

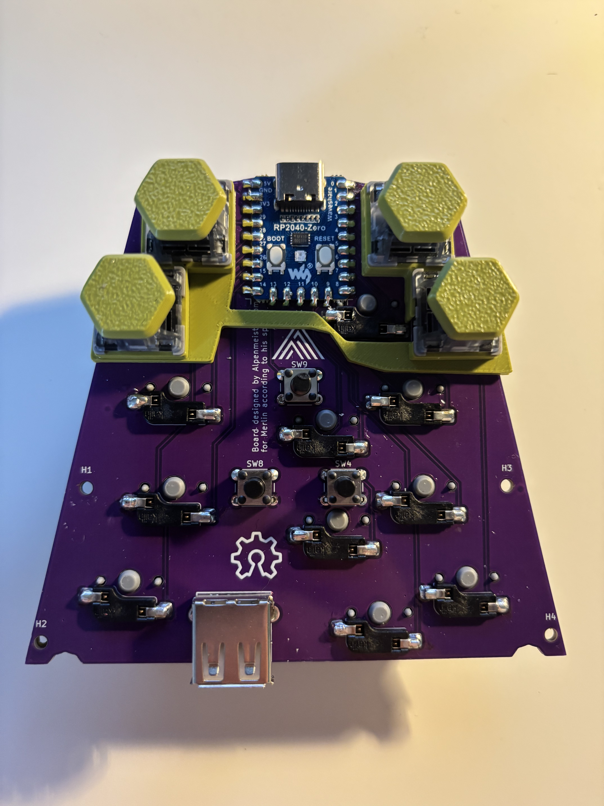
[picture p4: em-controller-2/pictures/pcb-top-view.jpeg]
em-controller-2/pictures/pcb-top-view.jpeg
