MerlinDesigns/hardware/em-controller-2/pictures/pcb-bottom-view.jpeg

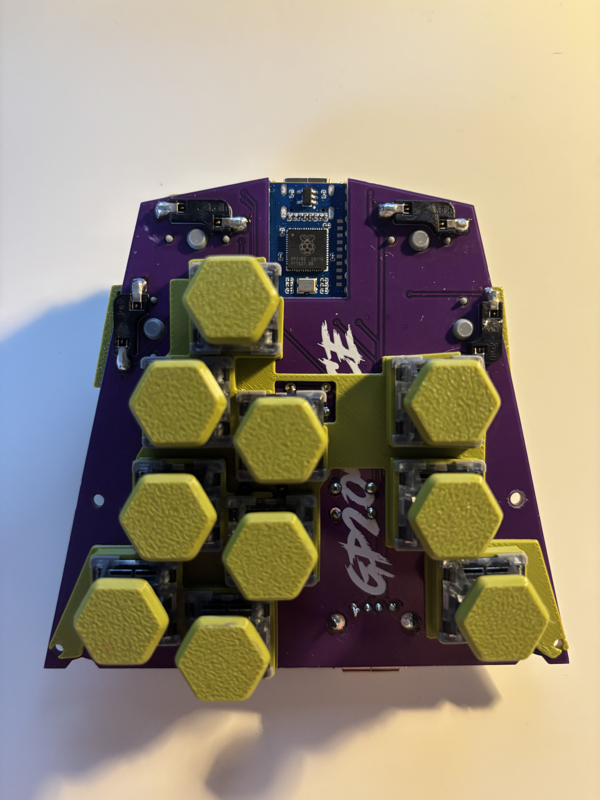
[picture p5: em-controller-2/pictures/pcb-bottom-view.jpeg]
em-controller-2/pictures/pcb-bottom-view.jpeg
