MerlinDesigns/hardware/em-controller-2/pictures/inside-top.jpg

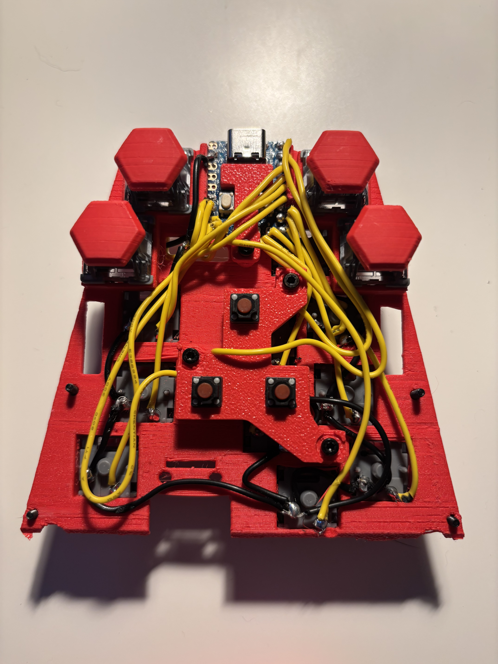
[picture p6: em-controller-2/pictures/inside-top.jpg]
em-controller-2/pictures/inside-top.jpg
