MerlinDesigns/hardware/em-controller-2/pictures/inside-bottom.jpg

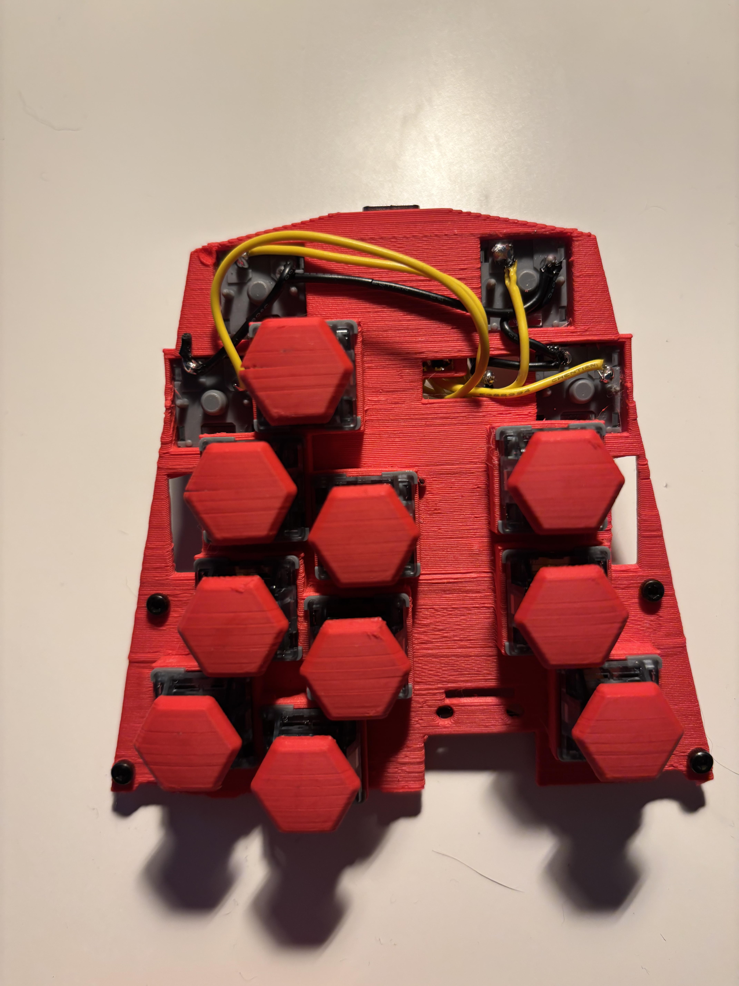
[picture p7: em-controller-2/pictures/inside-bottom.jpg]
em-controller-2/pictures/inside-bottom.jpg
