MerlinDesigns/hardware/em-controller/pictures/inside-pic.jpeg

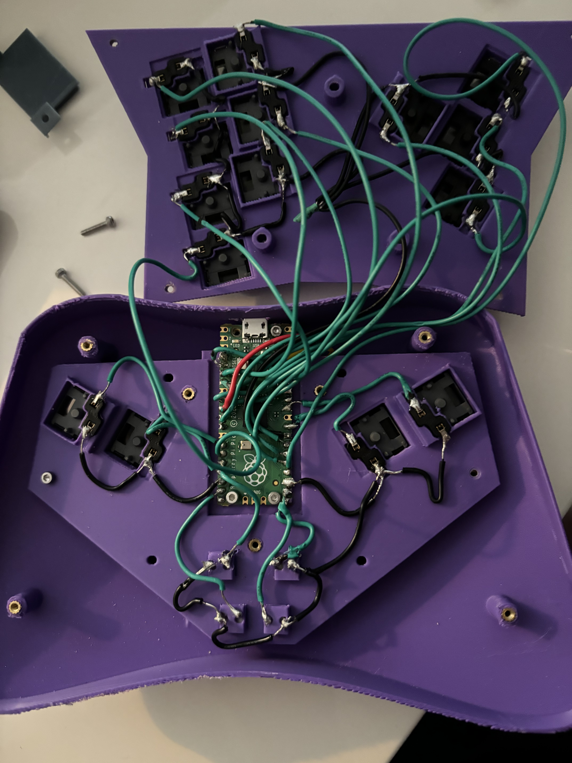
[picture p11: em-controller/pictures/inside-pic.jpeg]
em-controller/pictures/inside-pic.jpeg
